17o2/bluetooth-minidisc/pcb/btmdpcb_v04_eval/btmdpcb_v04_eval.kicad_pcb

## KiCad design pcb/btmdpcb_v04_eval/btmdpcb_v04_eval.kicad_pcb (2025-04-06)

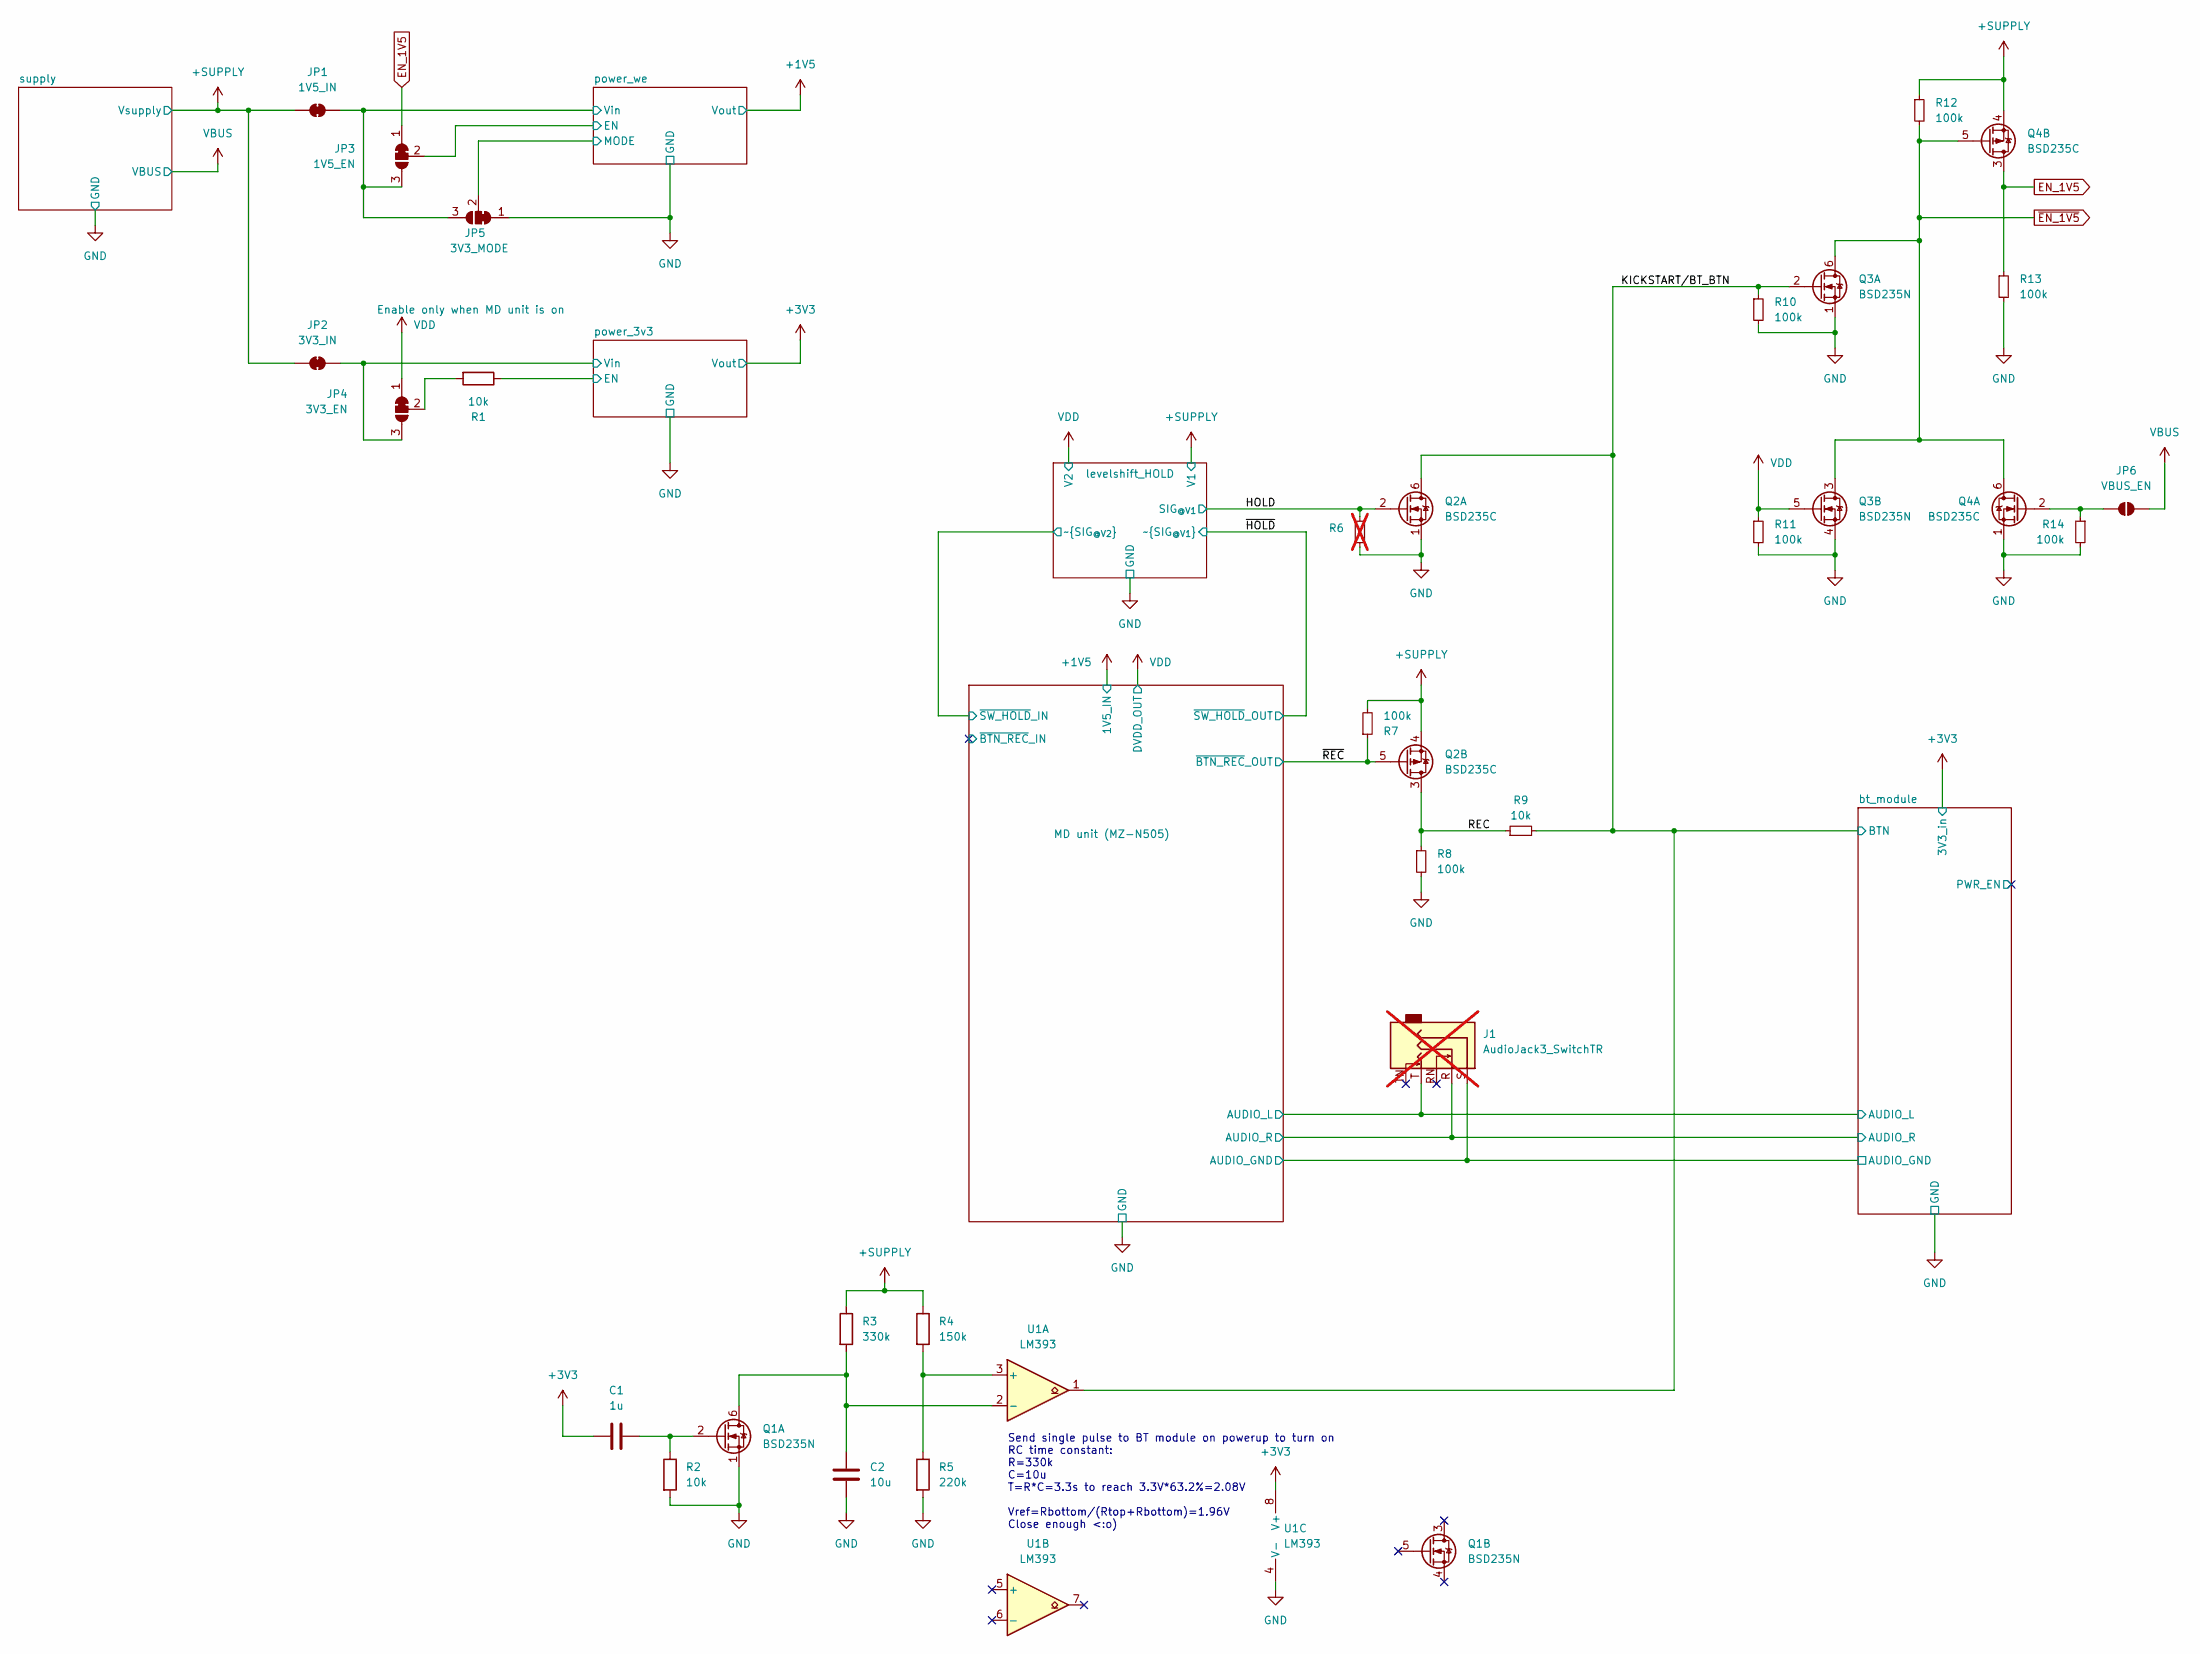
[picture p1: schematic btmdpcb_v04_eval.kicad_sch, BTMD: Bluetooth Minidisc]

Parts:
C1: 1u; C_0805_2012Metric_Pad1.18x1.45mm_HandSolder
C2: 10u; C_0805_2012Metric_Pad1.18x1.45mm_HandSolder
J1: AudioJack3_SwitchTR; not fitted
JP1: 1V5_IN; SolderJumper-2_P1.3mm_Bridged_RoundedPad1.0x1.5mm
JP2: 3V3_IN; SolderJumper-2_P1.3mm_Bridged_RoundedPad1.0x1.5mm
JP3: 1V5_EN; SolderJumper-3_P1.3mm_Bridged12_RoundedPad1.0x1.5mm
JP4: 3V3_EN; SolderJumper-3_P1.3mm_Bridged12_RoundedPad1.0x1.5mm
JP5: 3V3_MODE; SolderJumper-3_P1.3mm_Bridged12_RoundedPad1.0x1.5mm
JP6: VBUS_EN; SolderJumper-2_P1.3mm_Open_RoundedPad1.0x1.5mm
Q1, Q3: BSD235N; SOT-363_SC-70-6_Handsoldering
Q2, Q4: BSD235C; SOT-363_SC-70-6_Handsoldering
R1, R2, R9: 10k; R_0805_2012Metric_Pad1.20x1.40mm_HandSolder
R3: 330k; R_0805_2012Metric_Pad1.20x1.40mm_HandSolder
R4: 150k; R_0805_2012Metric_Pad1.20x1.40mm_HandSolder
R5: 220k; R_0805_2012Metric_Pad1.20x1.40mm_HandSolder
R6: not fitted
R7, R8, R10, R11, R12, R13, R14: 100k; R_0805_2012Metric_Pad1.20x1.40mm_HandSolder
U1: LM393; SOT-23-8_Handsoldering

Connections:
+3V3: C1.1, U1.8 (V+); also elsewhere on the board
+SUPPLY: JP1.1 (A), JP2.1 (A), Q2.4 (SP), Q4.4 (SP), R3.1, R4.1, R7.2, R12.1; also elsewhere on the board
/HOLD: Q2.2 (GN), R6.1; also elsewhere on the board
/KICKSTART/BT_BTN: Q2.6 (DN), Q3.2 (G1), R9.2, R10.1, U1.1; also elsewhere on the board
/REC: Q2.3 (DP), R8.1, R9.1
/power_3v3/EN: R1.1; also elsewhere on the board
/power_3v3/Vin: JP2.2 (B), JP4.3 (B); also elsewhere on the board
/power_we/EN: JP3.2 (C); also elsewhere on the board
/power_we/MODE: JP5.2 (C); also elsewhere on the board
/power_we/Vin: JP1.2 (B), JP3.3 (B), JP5.3 (B); also elsewhere on the board
/~REC: Q2.5 (GP), R7.1; also elsewhere on the board
EN_1V5: JP3.1 (A), Q4.3 (DP), R13.1
GND: C2.2, JP5.1 (A), Q1.1 (S1), Q2.1 (SN), Q3.1 (S1), Q3.4 (S2), Q4.1 (SN), R2.2, R5.2, R6.2, R8.2, R10.2, R11.2, R13.2, R14.2, U1.4 (V-); also elsewhere on the board
unnamed: JP4.2 (C), R1.2
unnamed: JP6.1 (A), Q4.2 (GN), R14.1
unnamed: C2.1, Q1.6 (D1), R3.2, U1.2 (-)
unnamed: C1.2, Q1.2 (G1), R2.1
unnamed: R4.2, R5.1, U1.3 (+)
VBUS: JP6.2 (B); also elsewhere on the board
VDD: JP4.1 (A), Q3.5 (G2), R11.1; also elsewhere on the board
~EN_1V5: Q3.3 (D2), Q3.6 (D1), Q4.5 (GP), Q4.6 (DN), R12.2

Notes on the sheet:
Send single pulse to BT module on powerup to turn on RC time constant: R=330k C=10u T=R*C=3.3s to reach 3.3V*63.2%=2.08V Vref=Rbottom/(Rtop+Rbottom)=1.96V Close enough <:o)

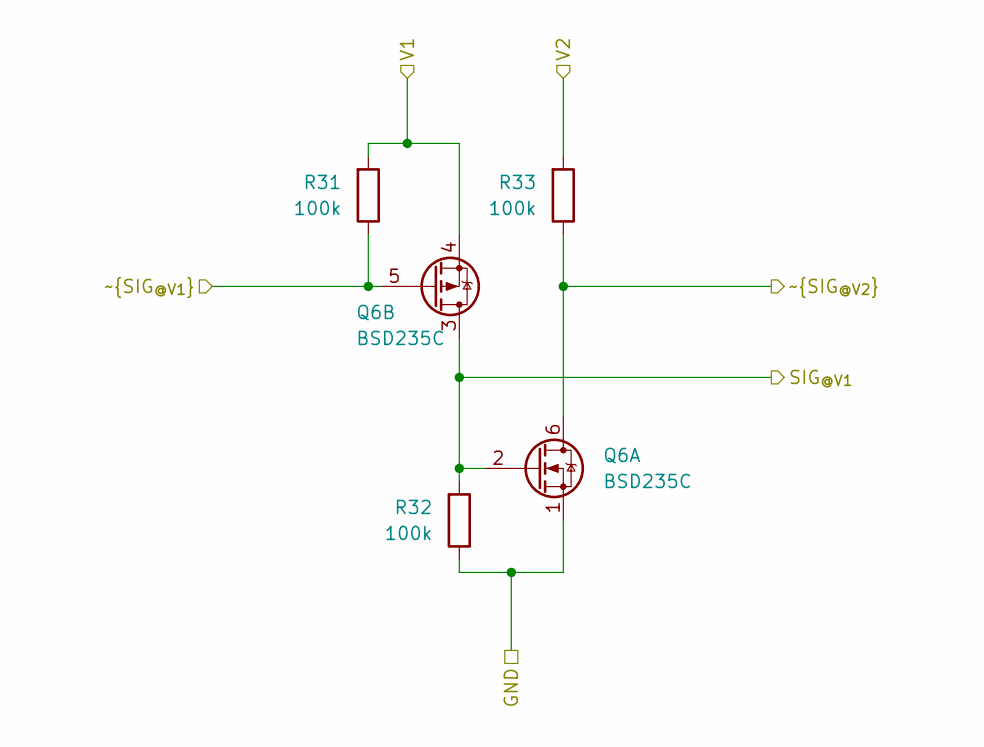
[picture p2: schematic dual_mosfet.kicad_sch]

Parts:
Q6: BSD235C; SOT-363_SC-70-6_Handsoldering
R31, R32, R33: 100k; R_0805_2012Metric_Pad1.20x1.40mm_HandSolder

Connections:
+SUPPLY: Q6.4 (SP), R31.2; also elsewhere on the board
/HOLD: Q6.2 (GN), Q6.3 (DP), R32.2; also elsewhere on the board
/MD unit (MZ-N505)/~SW_HOLD_IN: Q6.6 (DN), R33.1; also elsewhere on the board
/~HOLD: Q6.5 (GP), R31.1; also elsewhere on the board
GND: Q6.1 (SN), R32.1; also elsewhere on the board
VDD: R33.2; also elsewhere on the board

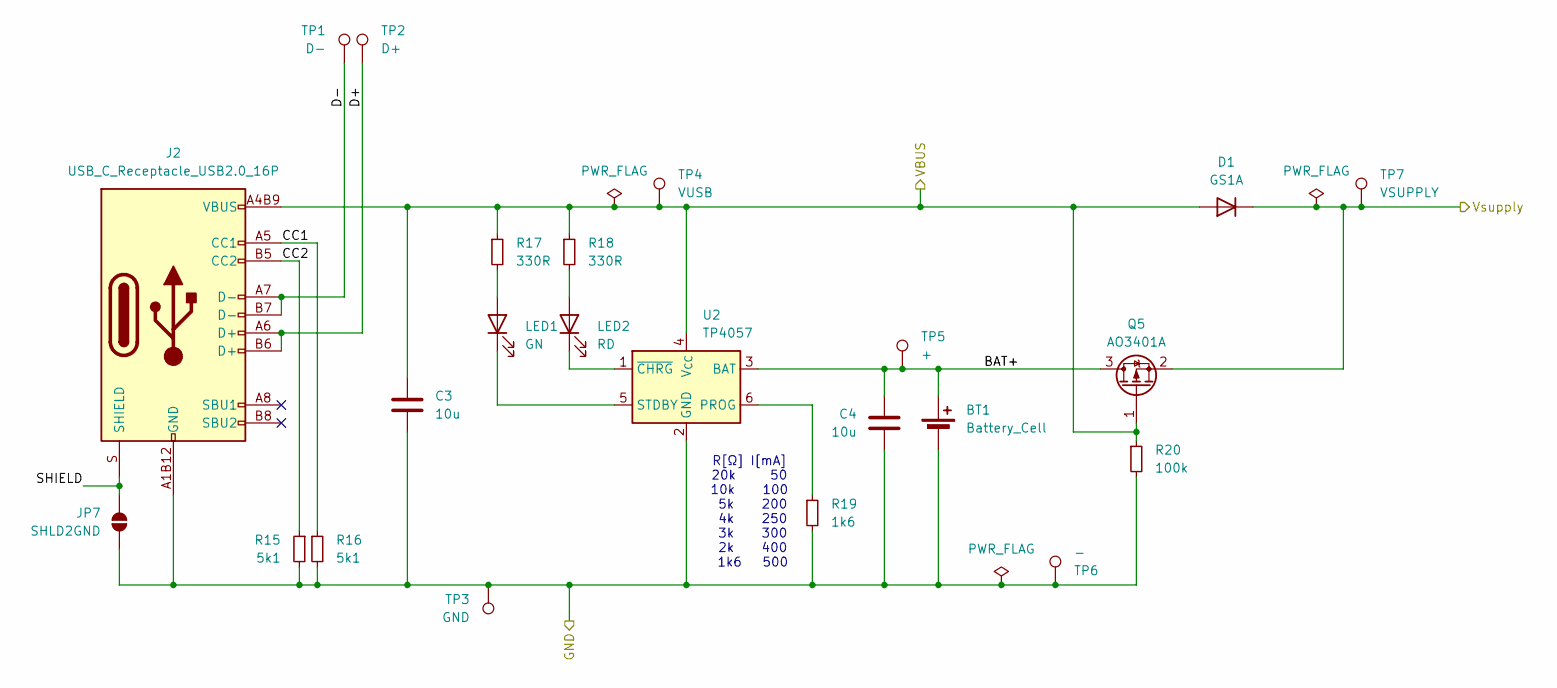
[picture p3: schematic supply.kicad_sch]

Parts:
BT1: Battery_Cell
C3, C4: 10u; C_0805_2012Metric_Pad1.18x1.45mm_HandSolder
D1: GS1A; D_SMA_Handsoldering
J2: USB_C_Receptacle_USB2.0_16P; USB-C-SMD_12P-P0.50-H-F_TYPE-C-31-M-14
JP7: SHLD2GND; SolderJumper-2_P1.3mm_Open_RoundedPad1.0x1.5mm
LED1: GN; LED_0805_2012Metric_Pad1.15x1.40mm_HandSolder
LED2: RD; LED_0805_2012Metric_Pad1.15x1.40mm_HandSolder
Q5: AO3401A; SOT-23_Handsoldering
R15, R16: 5k1; R_0805_2012Metric_Pad1.20x1.40mm_HandSolder
R17, R18: 330R; R_0805_2012Metric_Pad1.20x1.40mm_HandSolder
R19: 1k6; R_0805_2012Metric_Pad1.20x1.40mm_HandSolder
R20: 100k; R_0805_2012Metric_Pad1.20x1.40mm_HandSolder
TP1: D-; TestPoint_Pad_D1.0mm
TP2: D+; TestPoint_Pad_D1.0mm
TP3: GND; TestPoint_Pad_D1.0mm
TP4: VUSB; TestPoint_Pad_D1.0mm
TP5: +; TestPoint_Pad_D1.0mm
TP6: -; TestPoint_Pad_D1.0mm
TP7: VSUPPLY; TestPoint_Pad_D1.0mm
U2: TP4057; SOT-23-6_Handsoldering

Connections:
+SUPPLY: D1.1 (K), Q5.2 (S), TP7.1; also elsewhere on the board
/supply/BAT+: BT1.1 (+), C4.1, Q5.3 (D), TP5.1, U2.3 (BAT)
/supply/CC1: J2.A5 (CC1), R16.1
/supply/CC2: J2.B5 (CC2), R15.1
/supply/D+: J2.A6 (D+), J2.B6 (D+), TP2.1
/supply/D-: J2.A7 (D-), J2.B7 (D-), TP1.1
/supply/SHIELD: J2.S (SHIELD), JP7.1 (A)
GND: BT1.2 (-), C3.2, C4.2, J2.A1B12 (GND), J2.B1A12 (GND), JP7.2 (B), R15.2, R16.2, R19.2, R20.2, TP3.1, TP6.1, U2.2 (GND); also elsewhere on the board
unnamed: LED1.2 (A), R17.2
unnamed: LED1.1 (K), U2.5 (STDBY)
unnamed: LED2.2 (A), R18.2
unnamed: LED2.1 (K), U2.1 (~CHRG)
unnamed: R19.1, U2.6 (PROG)
VBUS: C3.1, D1.2 (A), J2.A4B9 (VBUS), J2.B4A9 (VBUS), Q5.1 (G), R17.1, R18.1, R20.1, TP4.1, U2.4 (V_{CC}); also elsewhere on the board

Notes on the sheet:
R[Ω] I[mA] 20k 50 10k 100 5k 200 4k 250 3k 300 2k 400 1k6 500

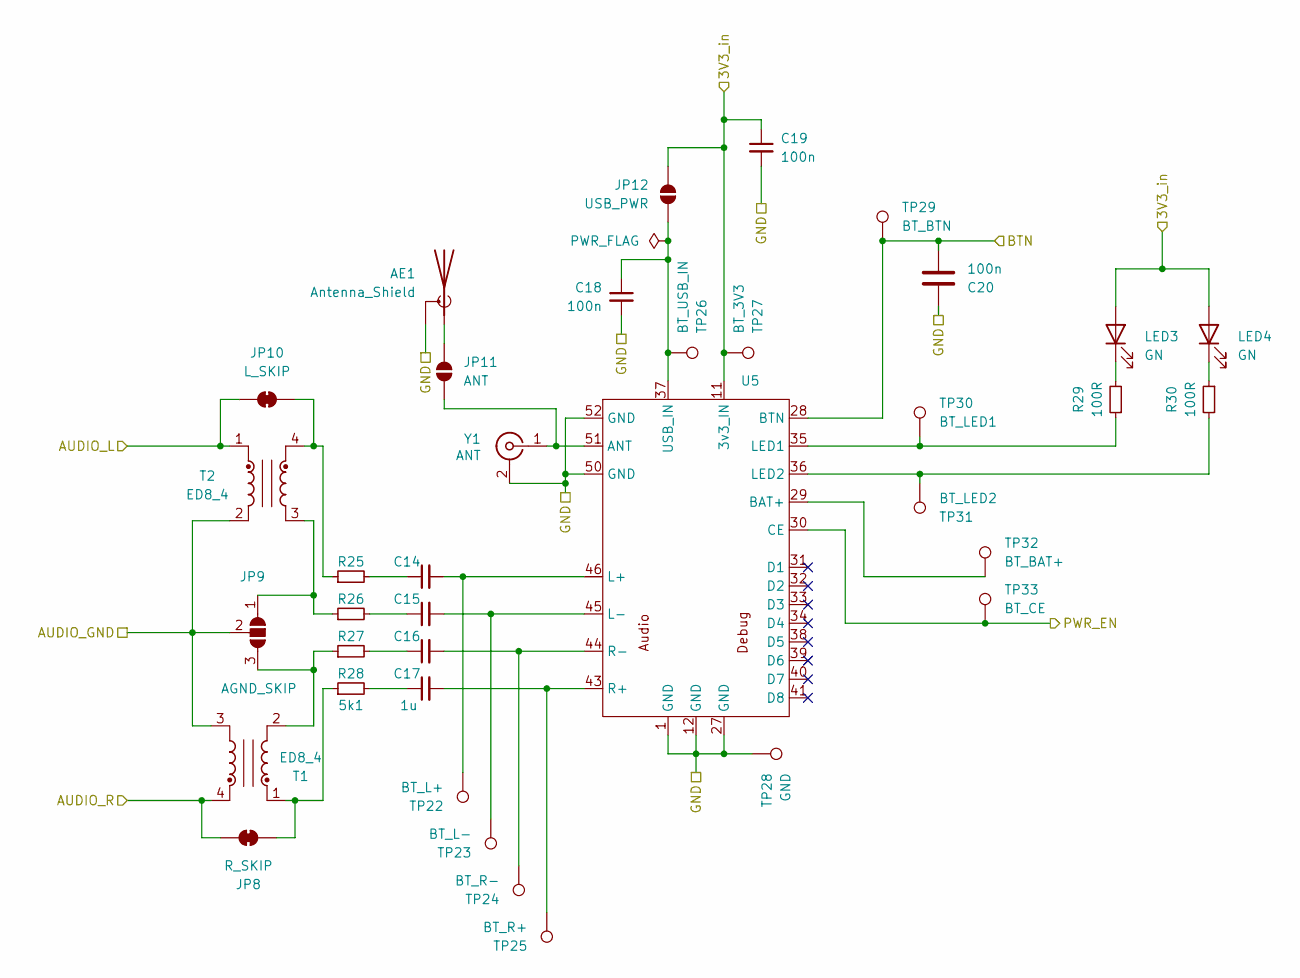
[picture p4: schematic bt_module.kicad_sch]

Parts:
AE1: Antenna_Shield; Texas_SWRA117D_2.4GHz_Left
C14, C15, C16, C17: 1u; C_0805_2012Metric_Pad1.18x1.45mm_HandSolder
C18, C19, C20: 100n; C_0805_2012Metric_Pad1.18x1.45mm_HandSolder
JP8: R_SKIP; SolderJumper-2_P1.3mm_Open_RoundedPad1.0x1.5mm
JP9: AGND_SKIP; SolderJumper-3_P1.3mm_Open_RoundedPad1.0x1.5mm
JP10: L_SKIP; SolderJumper-2_P1.3mm_Open_RoundedPad1.0x1.5mm
JP11: ANT; SolderJumper-2_P1.3mm_Open_RoundedPad1.0x1.5mm
JP12: USB_PWR; SolderJumper-2_P1.3mm_Open_RoundedPad1.0x1.5mm
LED3, LED4: GN; LED_0805_2012Metric_Pad1.15x1.40mm_HandSolder
R25, R26, R27, R28: 5k1; R_0805_2012Metric_Pad1.20x1.40mm_HandSolder
R29, R30: 100R; R_0805_2012Metric_Pad1.20x1.40mm_HandSolder
T1, T2: ED8_4; Transformer_ED8_4-Lead_10.5x8mm_P5mm
TP22: BT_L+; TestPoint_Pad_D1.0mm
TP23: BT_L-; TestPoint_Pad_D1.0mm
TP24: BT_R-; TestPoint_Pad_D1.0mm
TP25: BT_R+; TestPoint_Pad_D1.0mm
TP26: BT_USB_IN; TestPoint_Pad_D1.0mm
TP27: BT_3V3; TestPoint_Pad_D1.0mm
TP28: GND; TestPoint_Pad_D1.0mm
TP29: BT_BTN; TestPoint_Pad_D1.0mm
TP30: BT_LED1; TestPoint_Pad_D1.0mm
TP31: BT_LED2; TestPoint_Pad_D1.0mm
TP32: BT_BAT+; TestPoint_Pad_D1.0mm
TP33: BT_CE; TestPoint_Pad_D1.0mm
U5: bt_audio_smd
Y1: ANT; U.FL_Molex_MCRF_73412-0110_Vertical

Connections:
+3V3: C19.1, JP12.1 (A), LED3.2 (A), LED4.2 (A), TP27.1, U5.11 (3v3_IN); also elsewhere on the board
/KICKSTART/BT_BTN: C20.2, TP29.1, U5.28 (BTN); also elsewhere on the board
/MD unit (MZ-N505)/AUDIO_GND: JP9.2 (C), T1.3, T2.2; also elsewhere on the board
/MD unit (MZ-N505)/AUDIO_L: JP10.1 (A), T2.1; also elsewhere on the board
/MD unit (MZ-N505)/AUDIO_R: JP8.1 (A), T1.4; also elsewhere on the board
/bt_module/PWR_EN: TP33.1, U5.30 (CE)
GND: AE1.2 (Shield), C18.2, C19.2, C20.1, TP28.1, U5.1 (GND), U5.12 (GND), U5.27 (GND), U5.50 (GND), U5.52 (GND), Y1.2 (Ext); also elsewhere on the board
unnamed: AE1.1 (A), JP11.1 (A)
unnamed: C14.1, R25.2
unnamed: C15.1, R26.2
unnamed: C16.1, R27.2
unnamed: C17.1, R28.2
unnamed: JP8.2 (B), R28.1, T1.1
unnamed: JP9.1 (A), R26.1, T2.3
unnamed: JP9.3 (B), R27.1, T1.2
unnamed: JP10.2 (B), R25.1, T2.4
unnamed: JP11.2 (B), U5.51 (ANT), Y1.1 (In)
unnamed: C18.1, JP12.2 (B), TP26.1, U5.37 (USB_IN)
unnamed: LED3.1 (K), R29.2
unnamed: LED4.1 (K), R30.1
unnamed: TP32.1, U5.29 (BAT+)
unnamed: C14.2, TP22.1, U5.46 (L+)
unnamed: C15.2, TP23.1, U5.45 (L-)
unnamed: R29.1, TP30.1, U5.35 (LED1)
unnamed: R30.2, TP31.1, U5.36 (LED2)
unnamed: C17.2, TP25.1, U5.43 (R+)
unnamed: C16.2, TP24.1, U5.44 (R-)

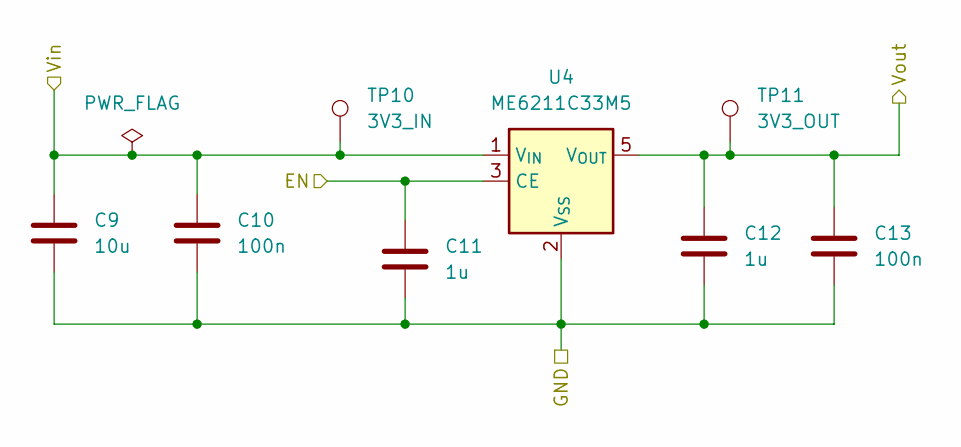
[picture p5: schematic power_3v3.kicad_sch]

Parts:
C9: 10u; C_0805_2012Metric_Pad1.18x1.45mm_HandSolder
C10, C13: 100n; C_0805_2012Metric_Pad1.18x1.45mm_HandSolder
C11, C12: 1u; C_0805_2012Metric_Pad1.18x1.45mm_HandSolder
TP10: 3V3_IN; TestPoint_Pad_D1.0mm
TP11: 3V3_OUT; TestPoint_Pad_D1.0mm
U4: ME6211C33M5; SOT-23-5_HandSoldering

Connections:
+3V3: C12.1, C13.1, TP11.1, U4.5 (V_{OUT}); also elsewhere on the board
/power_3v3/EN: C11.1, U4.3 (CE); also elsewhere on the board
/power_3v3/Vin: C9.1, C10.1, TP10.1, U4.1 (V_{IN}); also elsewhere on the board
GND: C9.2, C10.2, C11.2, C12.2, C13.2, U4.2 (V_{SS}); also elsewhere on the board

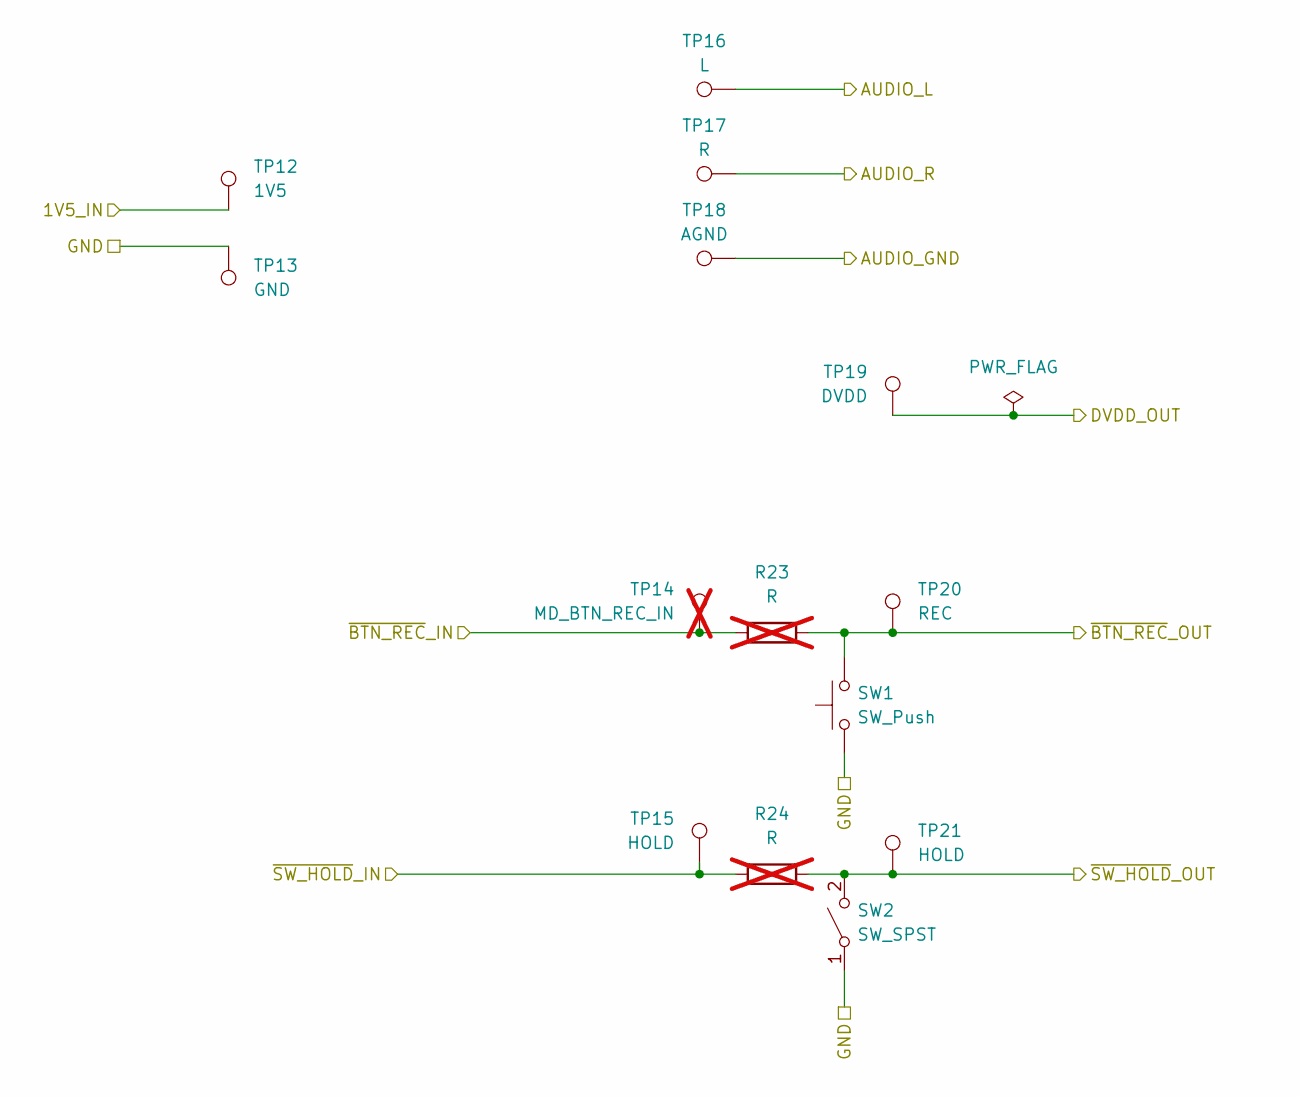
[picture p6: schematic md_unit.kicad_sch]

Parts:
R23, R24: R; not fitted
SW1: SW_Push
SW2: SW_SPST
TP12: 1V5; TestPoint_Pad_D1.0mm
TP13: GND; TestPoint_Pad_D1.0mm
TP14: MD_BTN_REC_IN; TestPoint_Pad_D1.0mm; not fitted
TP15, TP21: HOLD; TestPoint_Pad_D1.0mm
TP16: L; TestPoint_Pad_D1.0mm
TP17: R; TestPoint_Pad_D1.0mm
TP18: AGND; TestPoint_Pad_D1.0mm
TP19: DVDD; TestPoint_Pad_D1.0mm
TP20: REC; TestPoint_Pad_D1.0mm

Connections:
+1V5: TP12.1; also elsewhere on the board
/MD unit (MZ-N505)/AUDIO_GND: TP18.1; also elsewhere on the board
/MD unit (MZ-N505)/AUDIO_L: TP16.1; also elsewhere on the board
/MD unit (MZ-N505)/AUDIO_R: TP17.1; also elsewhere on the board
/MD unit (MZ-N505)/~SW_HOLD_IN: R24.1, TP15.1; also elsewhere on the board
/~HOLD: R24.2, SW2.2 (B), TP21.1; also elsewhere on the board
/~REC: R23.2, SW1.2, TP20.1; also elsewhere on the board
GND: SW1.1, SW2.1 (A), TP13.1; also elsewhere on the board
unnamed: R23.1, TP14.1
VDD: TP19.1; also elsewhere on the board

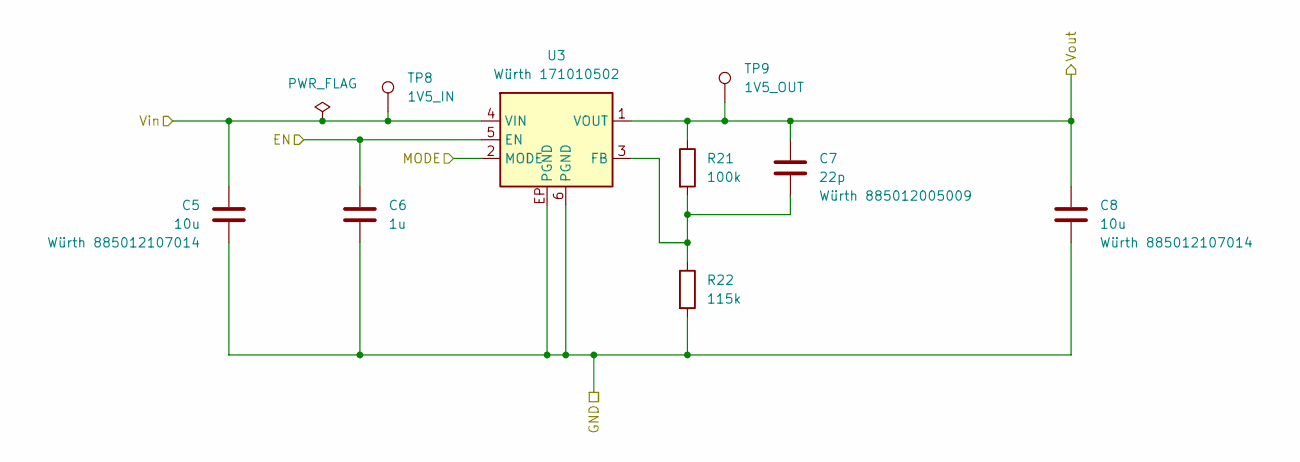
[picture p7: schematic power_we.kicad_sch]

Parts:
C5, C8: 10u; C_0805_2012Metric_Pad1.18x1.45mm_HandSolder
C6: 1u; C_0805_2012Metric_Pad1.18x1.45mm_HandSolder
C7: 22p; C_0402_1005Metric_Pad0.74x0.62mm_HandSolder
R21: 100k; R_0805_2012Metric_Pad1.20x1.40mm_HandSolder
R22: 115k; R_0805_2012Metric_Pad1.20x1.40mm_HandSolder
TP8: 1V5_IN; TestPoint_Pad_D1.0mm
TP9: 1V5_OUT; TestPoint_Pad_D1.0mm
U3: Würth 171010502; U_Wurth_WPME-VDMM_171010502

Connections:
+1V5: C7.1, C8.1, R21.1, TP9.1, U3.1 (VOUT); also elsewhere on the board
/power_we/EN: C6.1, U3.5 (EN); also elsewhere on the board
/power_we/MODE: U3.2 (MODE); also elsewhere on the board
/power_we/Vin: C5.1, TP8.1, U3.4 (VIN); also elsewhere on the board
GND: C5.2, C6.2, C8.2, R22.2, U3.6 (PGND), U3.EP (PGND); also elsewhere on the board
unnamed: C7.2, R21.2, R22.1, U3.3 (FB)

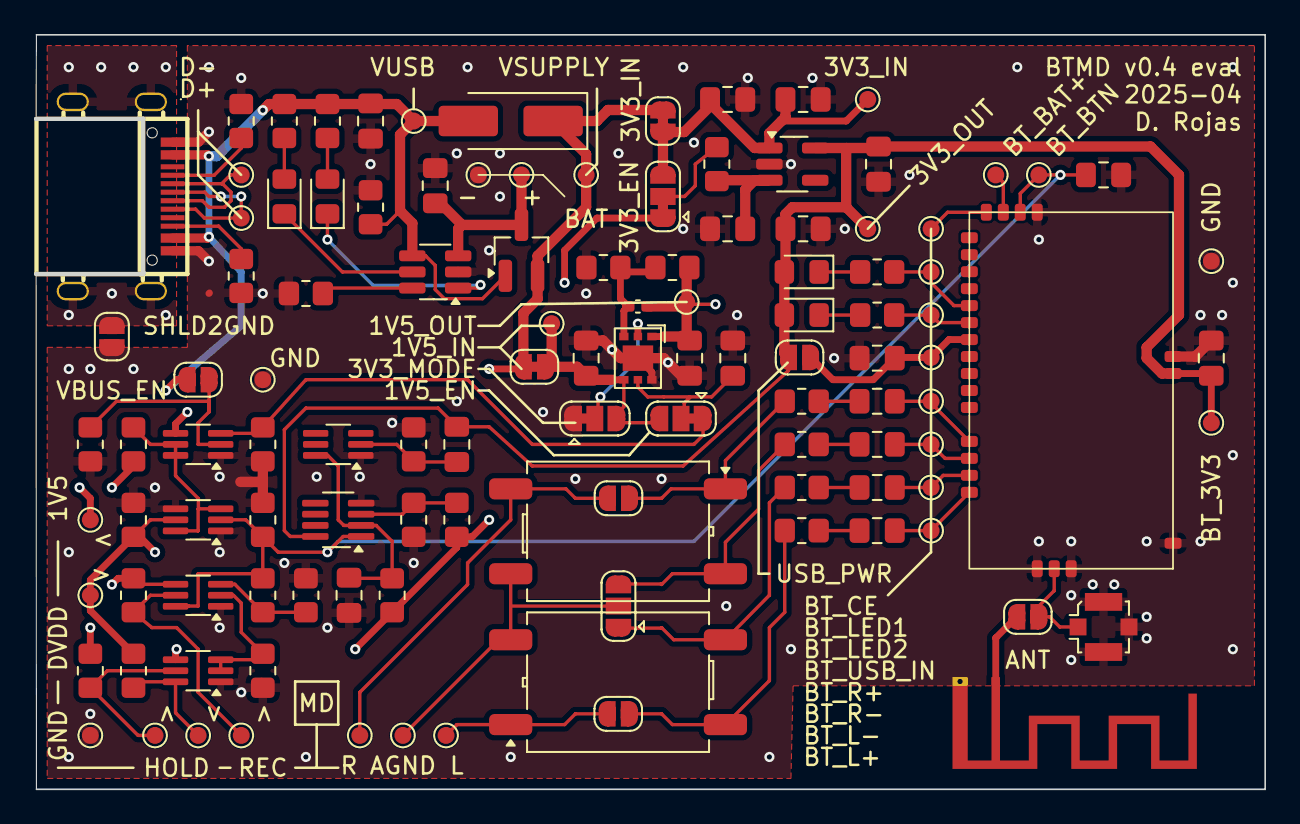
[picture p8: board btmdpcb_v04_eval.kicad_pcb from above]

Board: 4 copper layers, 72.4 x 44.4 mm, 115 parts (0 on the bottom side), 60 nets.
