17o2/bluetooth-minidisc/(commit log)

2025-04-01 First draft of v0.4 PCB
    [btmdpcb.kicad_pcb, btmdpcb.kicad_sch]
2025-04-01 [WIP] Redo schematic for powering from 3.7V LiPo
    [btmdpcb.kicad_sch]
2025-04-01 [WIP] Design eval board for step-down converters, other features
    [buck_test.kicad_pcb, buck_test.kicad_sch]
2025-04-01 [WIP] Tests to allow mounting BT module coplanar with PCB
    [buck_test.kicad_pcb]
2025-04-01 Update BT module symbol+footprint (correct power labels, add CE)
    [btmdpcb.kicad_pcb, btmdpcb.kicad_sch]
2025-04-01 Separate BT and Pololu libraries
    [btmdpcb.kicad_sch]
2025-04-01 [WIP] Design eval board for all relevant functions
    [bt_module.kicad_sch, btmdpcb.kicad_pcb, btmdpcb.kicad_sch, dual_mosfet.kicad_sch, md_unit.kicad_sch, power.kicad_sch, power_3v3.kicad_sch, power_ap3xxx.kicad_sch]
2025-04-01 Clean up schematic, implement all logic functionality
    [bt_module.kicad_sch, btmdpcb.kicad_pcb, btmdpcb.kicad_sch, dual_mosfet.kicad_sch, md_unit.kicad_sch, power_3v3.kicad_sch, power_ap3xxx.kicad_sch, power_mc34063.kicad_sch]
2025-04-01 Remove redundant regulators, simplify schematic
    [bt_module.kicad_sch, btmdpcb.kicad_pcb, btmdpcb.kicad_sch, dual_mosfet.kicad_sch, md_unit.kicad_sch, power_3v3.kicad_sch, power_we.kicad_sch, supply.kicad_sch]
2025-04-04 Use REC instead of PAUSE for power kickstart
    [btmdpcb.kicad_sch, dual_mosfet.kicad_sch]
2025-04-04 Simplify circuit; reduce transistor count
    [btmdpcb.kicad_sch]
2025-04-04 Add BT auto-powerup (RC circuit + comparator)
    [btmdpcb.kicad_sch, dual_mosfet.kicad_sch, power_we.kicad_sch, supply.kicad_sch]
2025-04-04 Create and use BSD235N symbol
    to replace 2N7000 N-MOSFETS used temporarily up to now
    [btmdpcb.kicad_pcb, btmdpcb.kicad_sch]
2025-04-04 Add missing libraries, assign all footprints
    [bt_module.kicad_sch, btmdpcb.kicad_pcb, btmdpcb.kicad_sch, dual_mosfet.kicad_sch, md_unit.kicad_sch, power_3v3.kicad_sch, power_we.kicad_sch, supply.kicad_sch]
2025-04-04 Correct footprints, fix issues on update PCB from schematic
    [bt_module.kicad_sch, btmdpcb.kicad_pcb, btmdpcb.kicad_sch, dual_mosfet.kicad_sch, power_3v3.kicad_sch, supply.kicad_sch]
2025-04-06 Layout PCB
    [bt_module.kicad_sch, btmdpcb.kicad_pcb, btmdpcb.kicad_sch, dual_mosfet.kicad_sch, md_unit.kicad_sch, power_3v3.kicad_sch, power_we.kicad_sch, supply.kicad_sch]
2025-04-06 Fix connectors & clearance; touch up PCB
    [btmdpcb.kicad_pcb, btmdpcb.kicad_sch, supply.kicad_sch]
2025-04-06 Export gerbers, order PCB
    [btmdpcb-B_Cu.gbl, btmdpcb-B_Mask.gbs, btmdpcb-B_Paste.gbp, btmdpcb-B_Silkscreen.gbo, btmdpcb-Edge_Cuts.gm1, btmdpcb-F_Cu.gtl, btmdpcb-F_Mask.gts, btmdpcb-F_Paste.gtp]
2025-04-06 Rename v0.4 eval board KiCad project
    [bt_module.kicad_sch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]
2025-04-06 Remove buck converter test project
    [buck_test.kicad_pcb, buck_test.kicad_sch]
